eklex/LEscalierD/sch/module/photo/P1090374.JPG

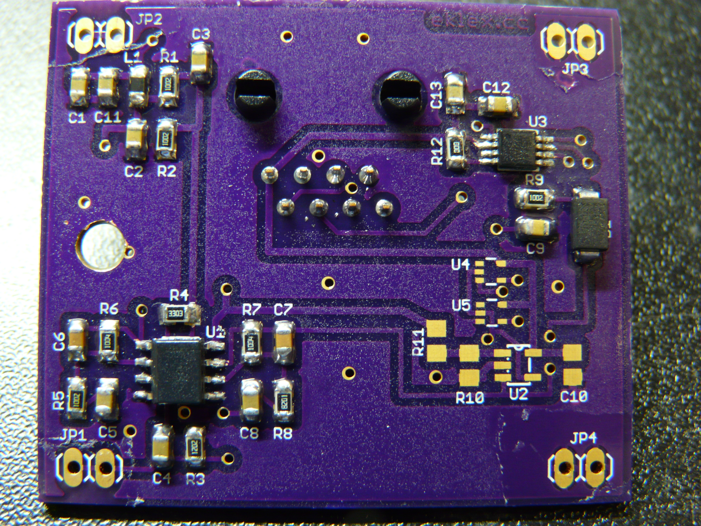
sch/module/photo/P1090374.JPG
