eklex/LEscalierD/sch/module/photo/P1090390.JPG

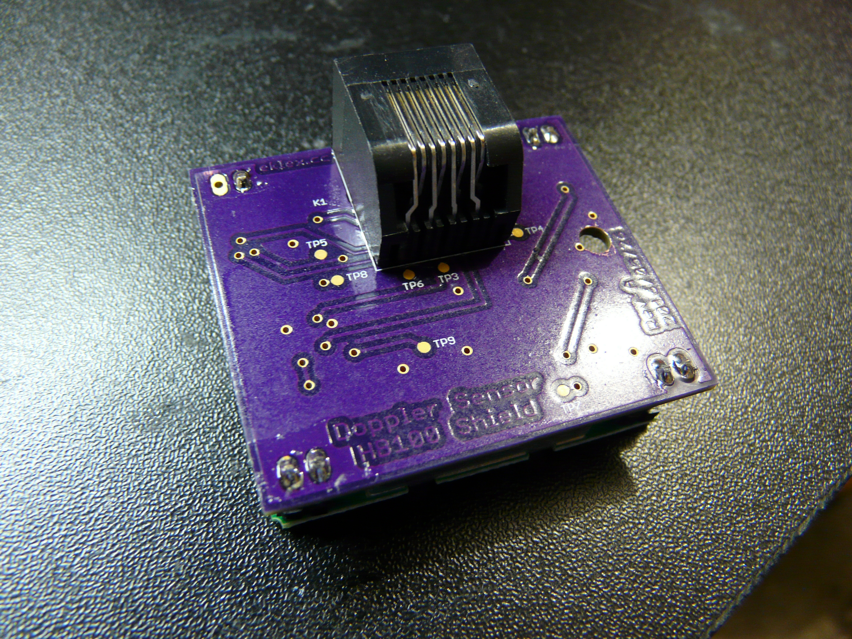
sch/module/photo/P1090390.JPG
