eklex/LEscalierD/sch/basecard/LEscalierD_brd_revA_bottom.png

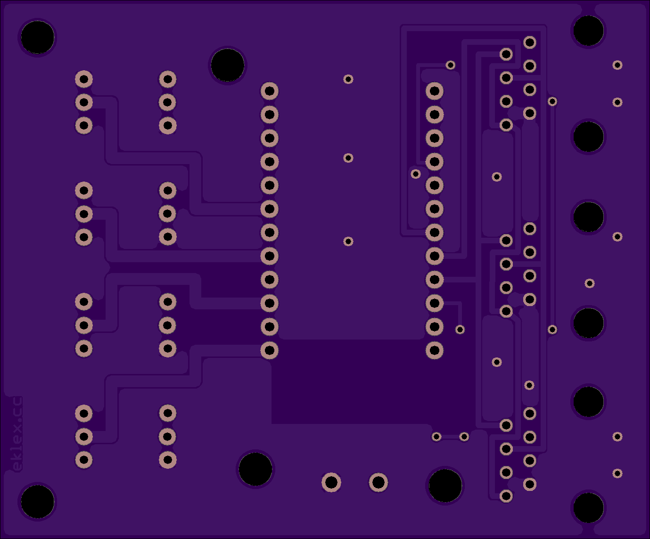
sch/basecard/LEscalierD_brd_revA_bottom.png
