eklex/LEscalierD/sch/basecard/LEscalierD_brd_revA_top.png

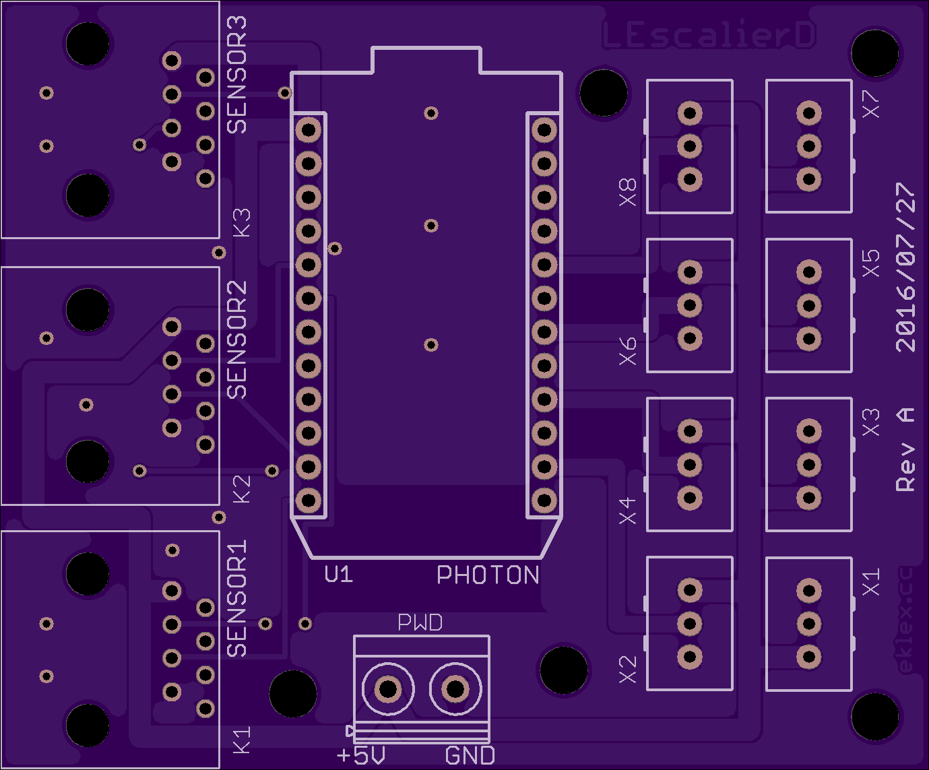
sch/basecard/LEscalierD_brd_revA_top.png
