eklex/LEscalierD/sch/basecard/photo/P1090511.JPG

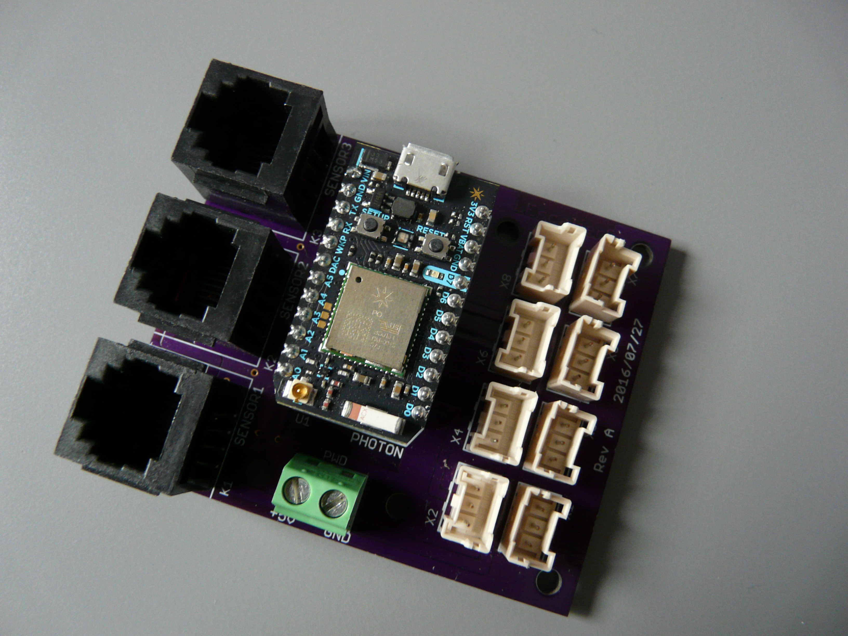
sch/basecard/photo/P1090511.JPG
