eklex/LEscalierD/sch/basecard/photo/P1090514.JPG

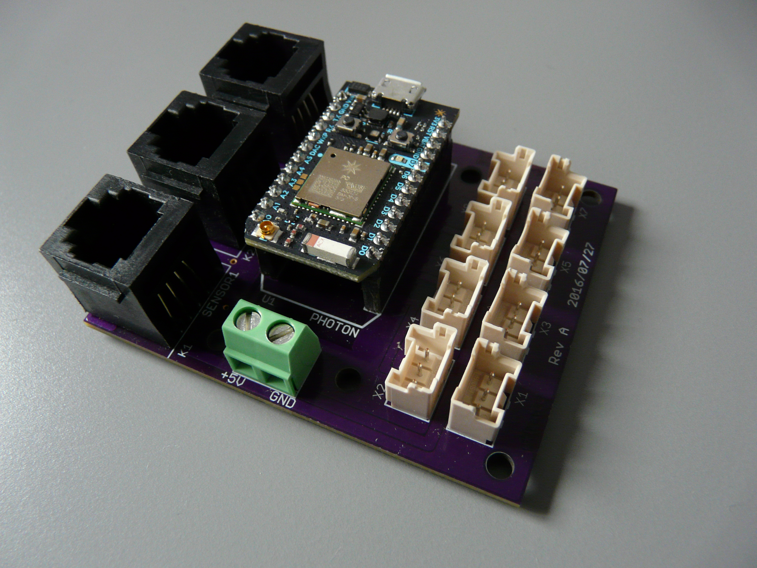
sch/basecard/photo/P1090514.JPG
