eklex/LEscalierD/sch/module/doppler_shield_brd_revB_bottom.png

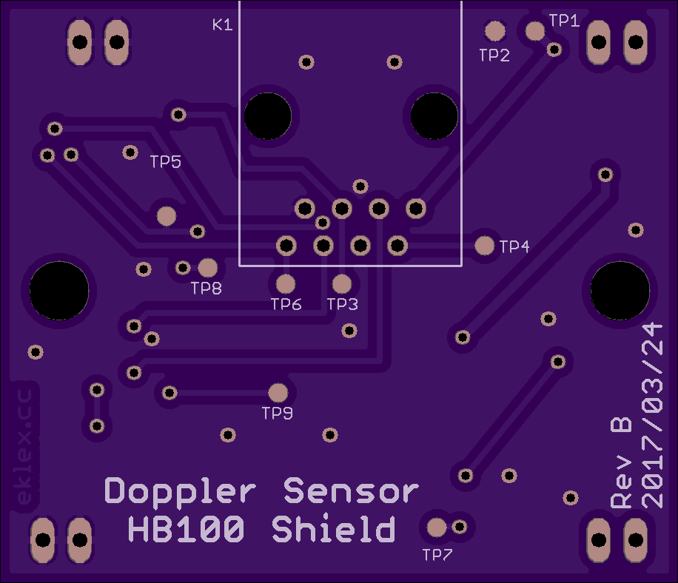
sch/module/doppler_shield_brd_revB_bottom.png
