eklex/LEscalierD/sch/module/doppler_shield_brd_revB_top.png

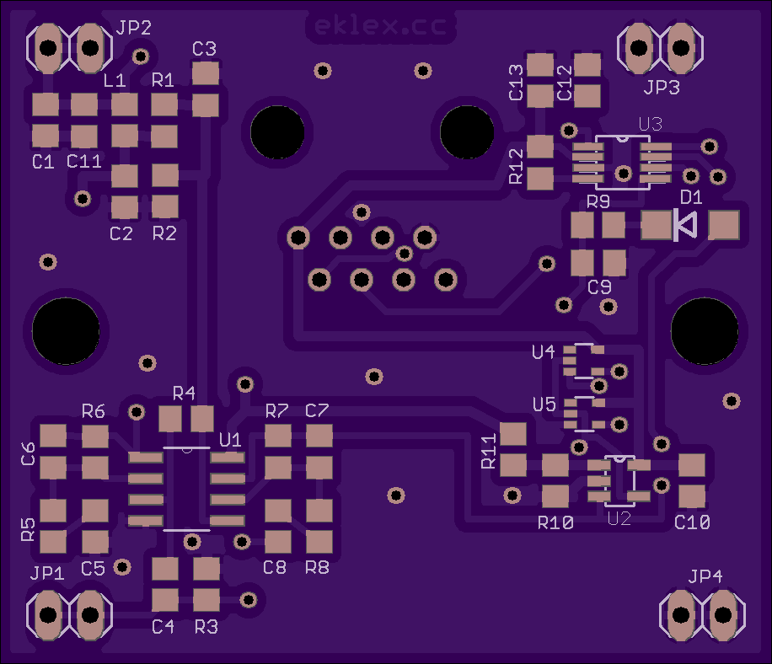
sch/module/doppler_shield_brd_revB_top.png
