eklex/LEscalierD/sch/module/photo/P1090385.JPG

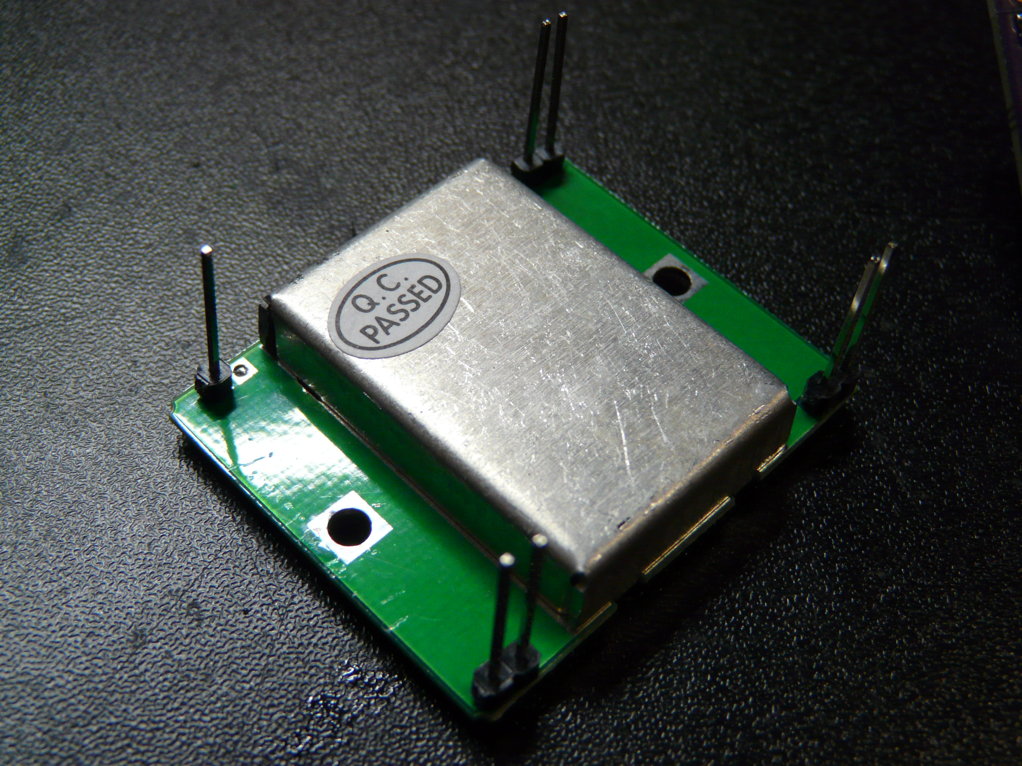
sch/module/photo/P1090385.JPG
