eklex/LEscalierD/sch/module/photo/P1090389.JPG

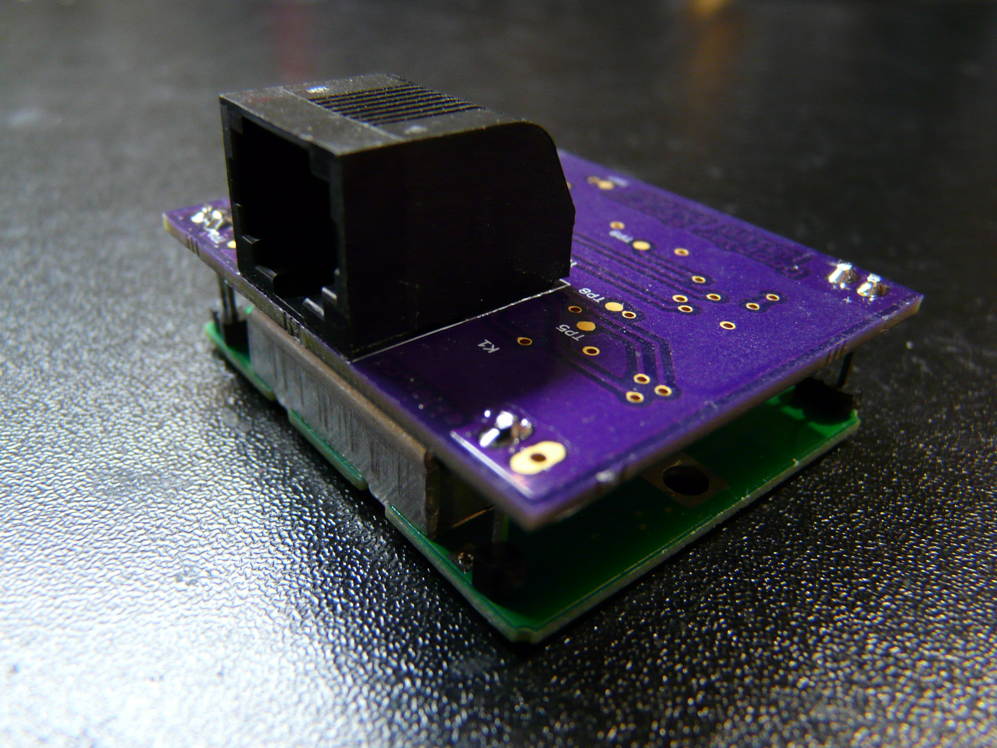
sch/module/photo/P1090389.JPG
