eklex/LEscalierD/sch/module/photo/P1090393.JPG

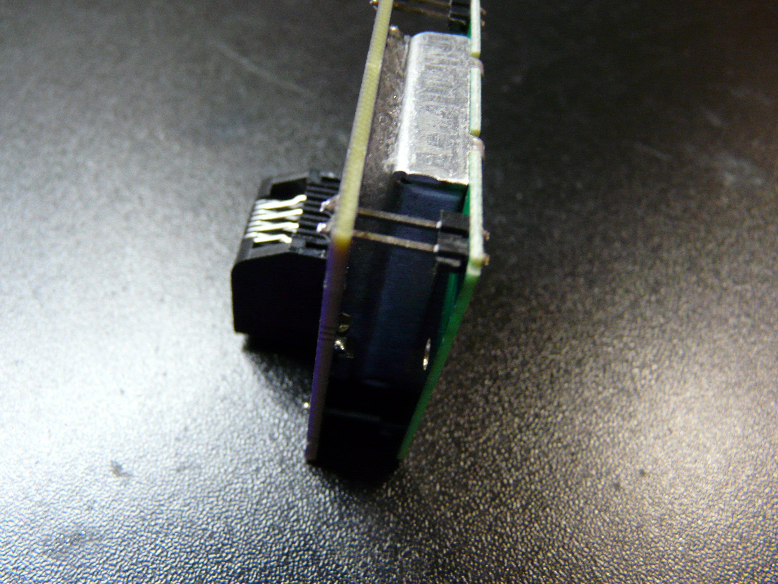
sch/module/photo/P1090393.JPG
