eklex/LEscalierD/sch/module/photo/P1090395.JPG

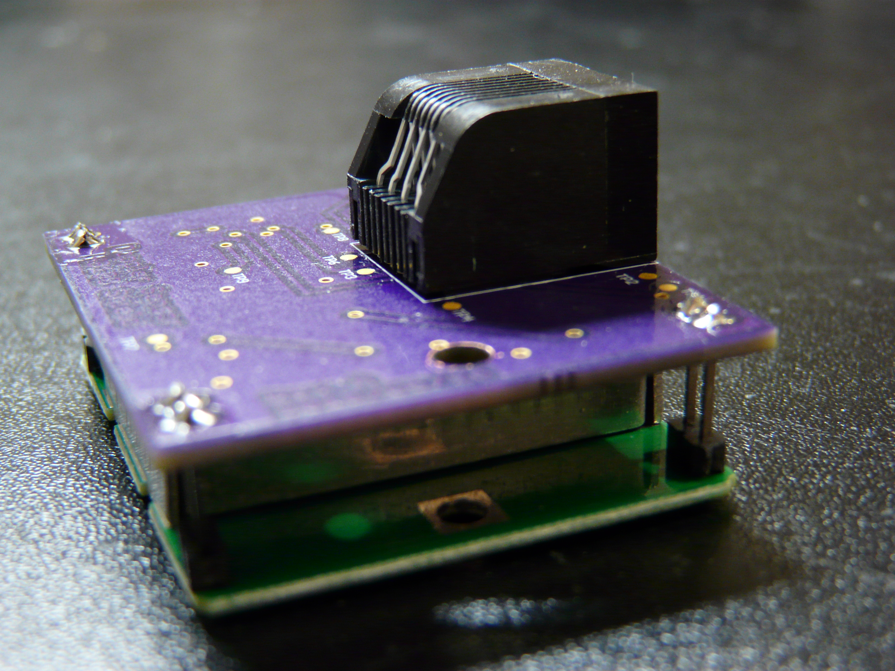
sch/module/photo/P1090395.JPG
