eklex/LEscalierD/sch/module/photo/P1090410.JPG

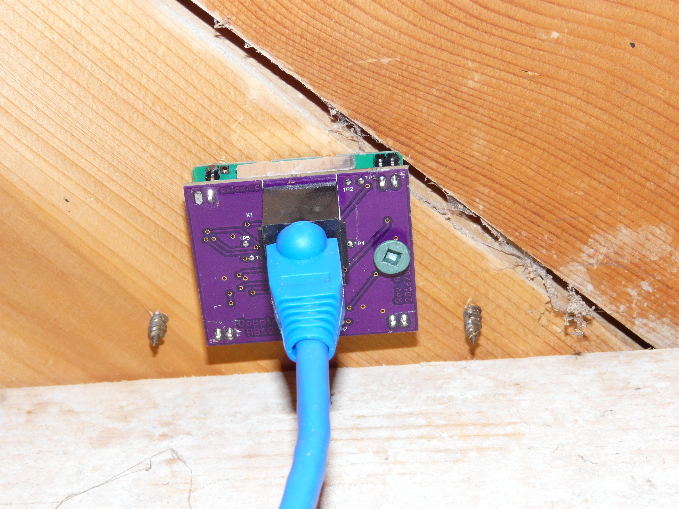
sch/module/photo/P1090410.JPG
