eklex/LEscalierD/sch/module/doppler_shield_bom_revB.xlsx

Sheet: BOM
Part | Quantity | Value | Eagle Device | Package | Part Number | Reference | Description
C1, C10, C13 | 3 | 100n | C-USC0805 | C0805 | 399-1170-1-ND (http://www.digikey.ca/scripts/DkSearch/dksus.dll?Detail&itemSeq=196558734&uq=635998726710660999) | SENS-C100N | CAP CER 0.1UF 50V X7R 0805
C2, C3, C9, C11, C12 | 5 | 10u | C-USC0805 | C0805 | 490-3886-1-ND (http://www.digikey.ca/scripts/DkSearch/dksus.dll?Detail&itemSeq=196558740&uq=635998726710650997) | SENS-C10U | CAP CER 10UF 16V X5R 0805
C4, C5, C8 | 3 | 4.7u | C-USC0805 | C0805 | 490-3335-1-ND (http://www.digikey.ca/scripts/DkSearch/dksus.dll?Detail&itemSeq=196558736&uq=635998726710660999) | SENS-C4.7U | CAP CER 4.7UF 25V X5R 0805
C6, C7 | 2 | 2.2n | C-USC0805 | C0805 | 399-1151-1-ND (http://www.digikey.ca/scripts/DkSearch/dksus.dll?Detail&itemSeq=196558733&uq=635998726710660999) | SENS-C2.2N | CAP CER 2200PF 50V X7R 0805
R1, R2, R5, R9, R10 | 5 | 10k | R-US_R0805 | R0805 | P10.0KCCT-ND (http://www.digikey.ca/scripts/DkSearch/dksus.dll?Detail&itemSeq=196558742&uq=635998726710640995) | SENS-R10K | RES SMD 10K OHM 1% 1/8W 0805
R3 | 1 | 12k | R-US_R0805 | R0805 | P12.0KCCT-ND (http://www.digikey.ca/scripts/DkSearch/dksus.dll?Detail&itemSeq=196558738&uq=635998726710640995) | SENS-R12K | RES SMD 12K OHM 1% 1/8W 0805
R4 | 1 | 330k | R-US_R0805 | R0805 | P330KCCT-ND (http://www.digikey.ca/scripts/DkSearch/dksus.dll?Detail&itemSeq=196558739&uq=635998726710650997) | SENS-R330K | RES SMD 330K OHM 1% 1/8W 0805
R6, R7 | 2 | 1M | R-US_R0805 | R0805 | P1.00MCCT-ND (http://www.digikey.ca/scripts/DkSearch/dksus.dll?Detail&itemSeq=196558737&uq=635998726710650997) | SENS-R1M | RES SMD 1M OHM 1% 1/8W 0805
R8, R11 | 2 | 8.2k | R-US_R0805 | R0805 | P8.20KCCT-ND (http://www.digikey.ca/scripts/DkSearch/dksus.dll?Detail&itemSeq=196558744&uq=635998726710630993) | SENS-R8.2K | RES SMD 8.2K OHM 1% 1/8W 0805
R12 | 1 | 0 | R-US_R0805 | R0805 | P0.0ACT-ND (http://www.digikey.ca/scripts/DkSearch/dksus.dll?Detail&itemSeq=198252034&uq=635998738667651919) | SENS-R0 | RES SMD 0.0 OHM JUMPER 1/8W 0805
L1 | 1 | FILTER | R-EU_R0805 | R0805 | HZ0805D102R-10 (http://www.digikey.ca/scripts/DkSearch/dksus.dll?Detail&itemSeq=198251175&uq=635998737494469204) | SENS-L1 | FERRITE BEAD 1 KOHM 0805 1LN
U1 | 1 | OPA2365AID | OPA2365AID | SOIC127 | OPA2365AIDR (http://www.digikey.ca/scripts/DkSearch/dksus.dll?Detail&itemSeq=198253137&uq=635998741464016119) | SENS-AOP | IC OPAMP GP 50MHZ RRO 8SOIC
U2 | 1 | MAX9031AUK+ | MAX9031AUK+ | SOT-23-5 | MAX9031AUK+TCT-ND (http://www.digikey.ca/scripts/DkSearch/dksus.dll?Detail&itemSeq=196558747&uq=635998738667611911) | SENS-CMP | IC COMPARATOR VOLT SGL SOT23-5
U3 | 1 | TSA7887ARMZ-REEL7 | AD7887ARMZ-REEL7 | 8-MSOP | TSA7887ARMZ-REEL (http://www.digikey.ca/scripts/DkSearch/dksus.dll?Detail&itemSeq=198253467&uq=635998743198149515) | SENS-ADC | IC ADC 12BIT 125KSPS 2CH 8-MSOP
U4 | 1 | 74LVC1G14DCK | 74LVC1G14DCK | SC-70-5 | SN74LVC1G14DCKR (http://www.digikey.ca/scripts/DkSearch/dksus.dll?Detail&itemSeq=198253730&uq=635998745416741352) | SENS-INV | IC SGL SCHMT-TRIG INVERT SC70-5
U5 | 1 | 74LVC1G17DCK | 74LVC1G17DCK | SC-70-5 | SN74LVC1G17DCKR (http://www.digikey.ca/scripts/DkSearch/dksus.dll?Detail&itemSeq=213396091&uq=636164644893759138) | SENS-BUF | IC BUFFER SCHMIT TRIG SC70-5
D1 | 1 | - | DIODE-DO214AC | DO-214AC | STPS1L30A (http://www.digikey.ca/scripts/DkSearch/dksus.dll?Detail&itemSeq=198253913&uq=635998746436135305) | SENS-D1 | DIODE SCHOTTKY 30V 1A SMA
K1 | 1 | - | 615008143721 | - | 615008143721 (http://www.digikey.ca/scripts/DkSearch/dksus.dll?Detail&itemSeq=196558735&uq=635998738667651919) | SENS-RJ45 | CONN MOD JACK 8P8C R/A UNSHLD
JP1, JP2, JP3, JP4 | 4 | - | PINHD-1X2 | 1X02 | Aliexpress (http://www.aliexpress.com/item/Free-Shipping-10pcs-1-40-40Pin-2-54mm-20mm-Long-Header-Pin-Male-Breakable-Pin-Header/1892073519.html) | SENS-CONN | PIN HEADER 2.54MM WIDTH 20MM LONG

Sheet: Eagle BOM
Part | Value | Device | Package | Description
C1 | 100n | C-USC0805 | C0805 | CAPACITOR, American symbol
C2 | 10u | C-USC0805 | C0805 | CAPACITOR, American symbol
C3 | 10u | C-USC0805 | C0805 | CAPACITOR, American symbol
C4 | 4.7u | C-USC0805 | C0805 | CAPACITOR, American symbol
C5 | 4.7u | C-USC0805 | C0805 | CAPACITOR, American symbol
C6 | 2.2n | C-USC0805 | C0805 | CAPACITOR, American symbol
C7 | 2.2nF | C-USC0805 | C0805 | CAPACITOR, American symbol
C8 | 4.7u | C-USC0805 | C0805 | CAPACITOR, American symbol
C9 | 10u | C-USC0805 | C0805 | CAPACITOR, American symbol
C10 | 100n | C-USC0805 | C0805 | CAPACITOR, American symbol
C11 | 10u | C-USC0805 | C0805 | CAPACITOR, American symbol
C12 | 10u | C-USC0805 | C0805 | CAPACITOR, American symbol
C13 | 100n | C-USC0805 | C0805 | CAPACITOR, American symbol
R1 | 10k | R-US_R0805 | R0805 | RESISTOR, American symbol
R2 | 10k | R-US_R0805 | R0805 | RESISTOR, American symbol
R3 | 12k | R-US_R0805 | R0805 | RESISTOR, American symbol
R4 | 330k | R-US_R0805 | R0805 | RESISTOR, American symbol
R5 | 10k | R-US_R0805 | R0805 | RESISTOR, American symbol
R6 | 1M | R-US_R0805 | R0805 | RESISTOR, American symbol
R7 | 1M | R-US_R0805 | R0805 | RESISTOR, American symbol
R8 | 8.2k | R-US_R0805 | R0805 | RESISTOR, American symbol
R9 | 10k | R-US_R0805 | R0805 | RESISTOR, American symbol
R10 | 10k | R-US_R0805 | R0805 | RESISTOR, American symbol
R11 | 8.2k | R-US_R0805 | R0805 | RESISTOR, American symbol
R12 | 0 | R-US_R0805 | R0805 | RESISTOR, American symbol
L1 | FILTER | R-EU_R0805 | R0805 | RESISTOR, European symbol
U1 | OPA2365AID | OPA2365AID | SOIC127P600X175-8N | OPERATIONAL AMPLIFIER
U2 | MAX9031AUK+ | MAX9031AUK+ | 21-0057F
U3 | TSA7887ARMZ-REEL7 | AD7887ARMZ-REEL7 | RM_8
U4 | 74LVC1G14DCK | 74LVC1G14DCK | SC70-5 | Single Schmitt-Trigger Inverter Gate
U5 | 74LVC1G17DCK | 74LVC1G17DCK | SC70-5 | Single Schmitt-Trigger Buffer
D1 |  | DIODE-DO214AC | DO214AC | DIODE
K1 | 615008143721 | 615008143721 | 615008143721 | WR-MJ Horizontal Plastic 8P8C Modular Jack Tab Down, 8 Pins=>Code : Con_I-O_MJ-H_Plastic_Down_615008143721
JP1 |  | PINHD-1X2 | 1X02 | PIN HEADER
JP2 |  | PINHD-1X2 | 1X02 | PIN HEADER
JP3 |  | PINHD-1X2 | 1X02 | PIN HEADER
JP4 |  | PINHD-1X2 | 1X02 | PIN HEADER
