eklex/LEscalierD/sch/basecard/LEscalierD_sch_revA.pdf

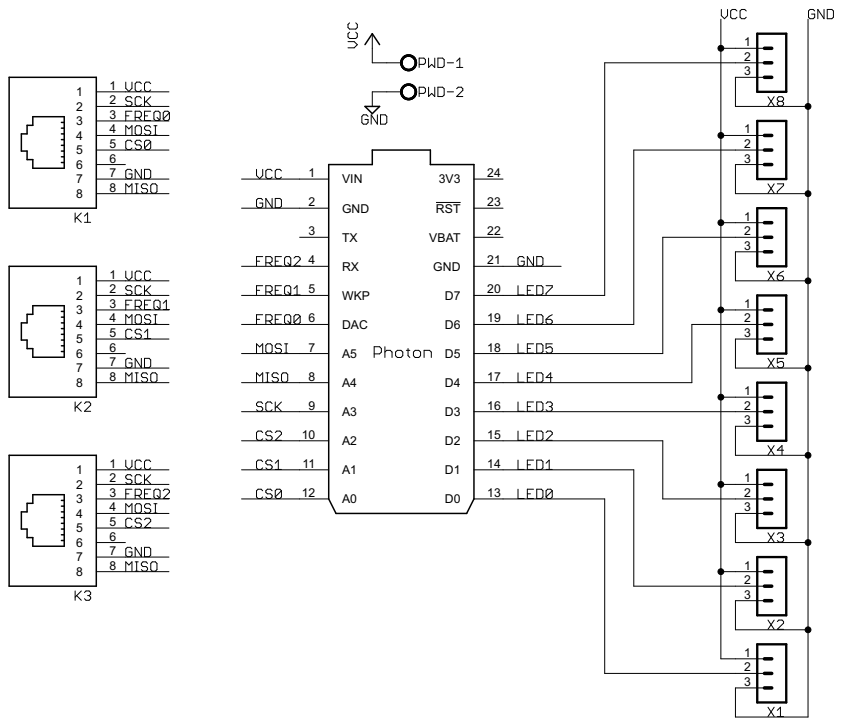
[picture p14: page 1]
