eklex/LEscalierD/sch/module/doppler_shield_sch_revB.pdf

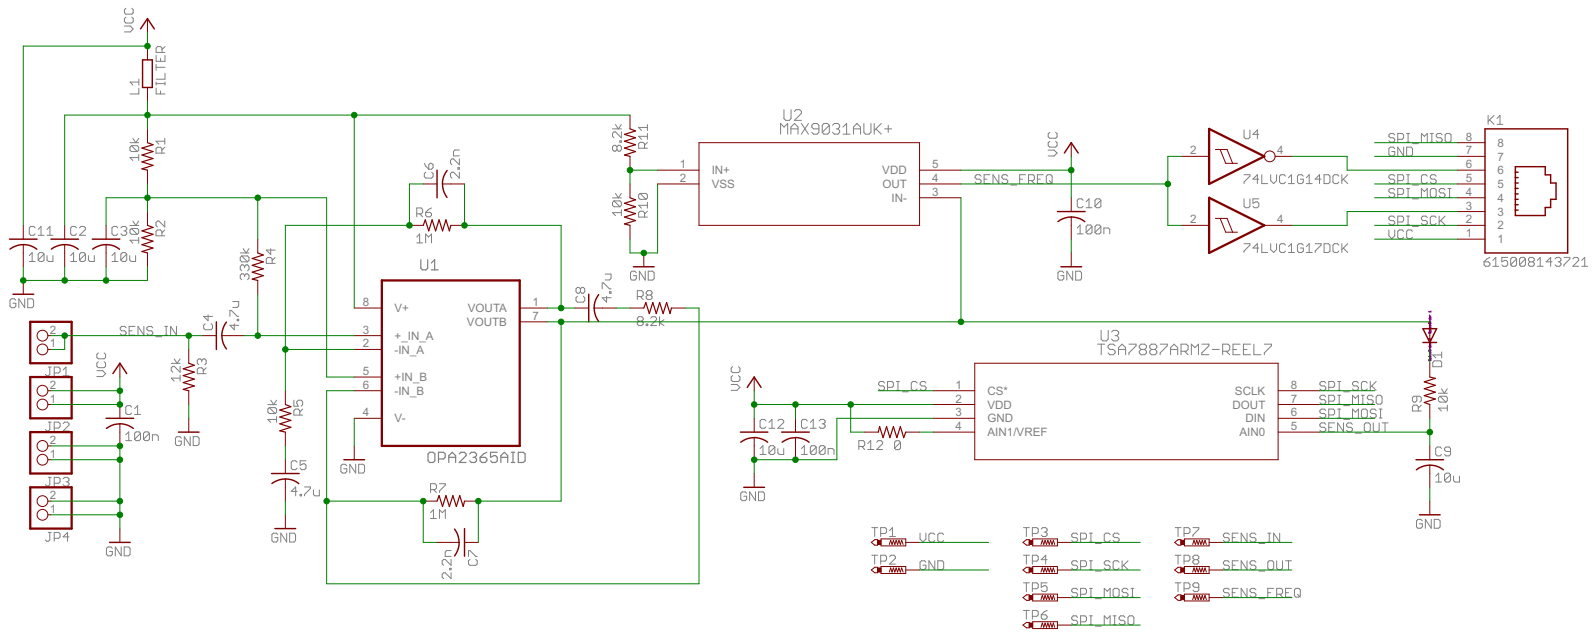
[picture p15: page 1]
