eklex/LEscalierD/sch/module/src/doppler_shield.brd

## EAGLE design sch/module/src/doppler_shield.brd (2017-03-25)

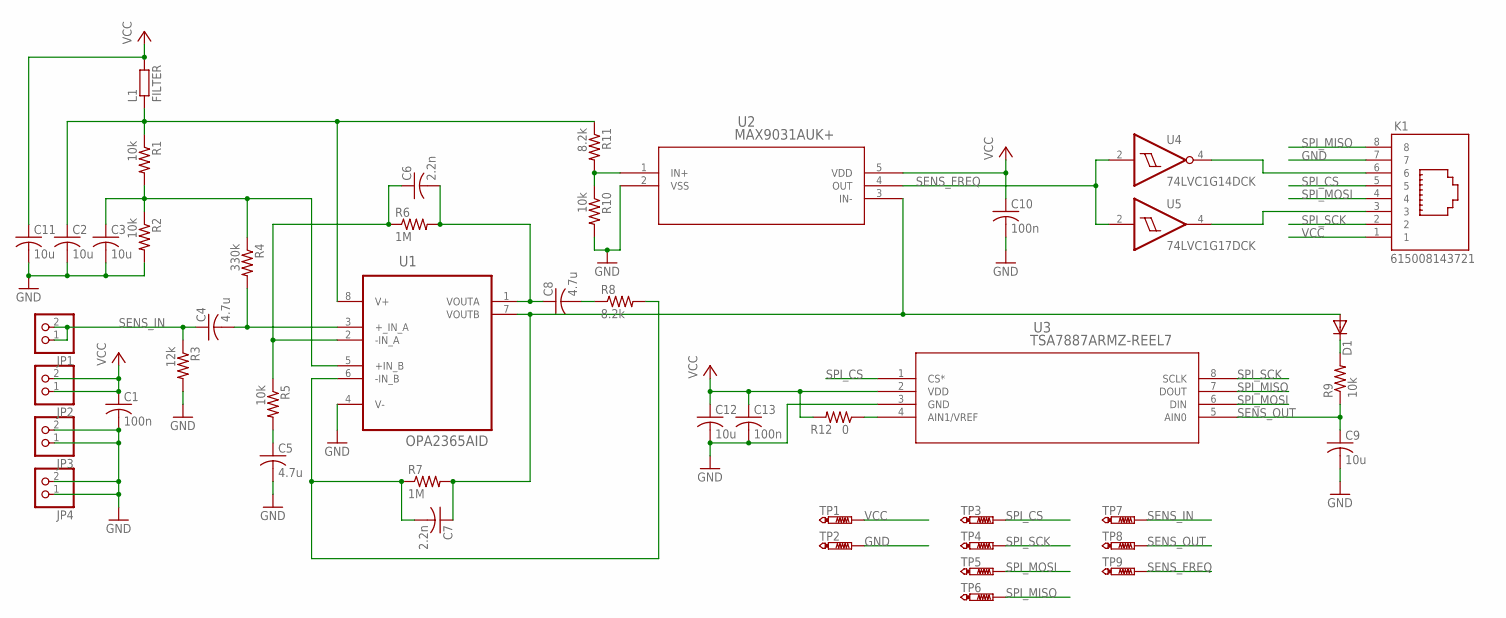
[picture p16: schematic doppler_shield.sch]

Parts:
C1, C10, C13: 100n; C0805
C2, C3, C9, C11, C12: 10u; C0805
C4, C5, C8: 4.7u; C0805
C6, C7: 2.2n; C0805
D1: DIODE-DO214AC; DO214AC
JP1, JP2, JP3, JP4: PINHD-1X2; 1X02
K1: 615008143721
L1: FILTER; R0805
R1, R2, R5, R9, R10: 10k; R0805
R3: 12k; R0805
R4: 330k; R0805
R6, R7: 1M; R0805
R8, R11: 8.2k; R0805
R12: 0; R0805
TP1, TP2, TP3, TP4, TP5, TP6, TP7, TP8, TP9: PTR1B1,27; B1,27
U1: OPA2365AID; SOIC127P600X175-8N
U2: MAX9031AUK+; 21-0057F
U3: TSA7887ARMZ-REEL7; RM_8
U4: 74LVC1G14DCK; SC70-5
U5: 74LVC1G17DCK; SC70-5

Connections:
GND: C1.2, C2.2, C3.2, C5.2, C9.2, C10.2, C11.2, C12.2, C13.2, JP3.1, JP3.2, JP4.1, JP4.2, K1.7, R2.2, R3.2, R10.2, TP2.TP, U1.4 (V-), U2.2 (VSS), U3.3 (GND), U4.3 (GND), U5.3 (GND)
unnamed: C3.1, R1.2, R2.1, R4.1, U1.5 (+IN_B)
unnamed: R10.1, R11.2, U2.1 (IN+)
unnamed: D1.C, R9.2
unnamed: R12.1, U3.4 (AIN1/VREF)
unnamed: K1.6, U4.4 (O)
unnamed: K1.3, U5.4 (O)
unnamed: C4.2, R4.2, U1.3 (+_IN_A)
unnamed: C5.1, R5.2
unnamed: C6.1, R5.1, R6.1, U1.2 (-IN_A)
unnamed: C6.2, C8.1, R6.2, U1.1 (VOUTA)
unnamed: C8.2, R8.1
unnamed: C7.2, R7.1, R8.2, U1.6 (-IN_B)
unnamed: C7.1, D1.A, R7.2, U1.7 (VOUTB), U2.3 (IN-)
SENS_FREQ: TP9.TP, U2.4 (OUT), U4.2 (I), U5.2 (I)
SENS_IN: C4.1, JP1.1, JP1.2, R3.1, TP7.TP
SENS_OUT: C9.1, R9.1, TP8.TP, U3.5 (AIN0)
SPI_CS: K1.5, TP3.TP, U3.1 (CS*)
SPI_MISO: K1.8, TP6.TP, U3.7 (DOUT)
SPI_MOSI: K1.4, TP5.TP, U3.6 (DIN)
SPI_SCK: K1.2, TP4.TP, U3.8 (SCLK)
VCC: C1.1, C10.1, C11.1, C12.1, C13.1, JP2.1, JP2.2, K1.1, L1.2, R12.2, TP1.TP, U2.5 (VDD), U3.2 (VDD), U4.5 (VCC), U5.5 (VCC)
VCC_AMP: C2.1, L1.1, R1.1, R11.1, U1.8 (V+)

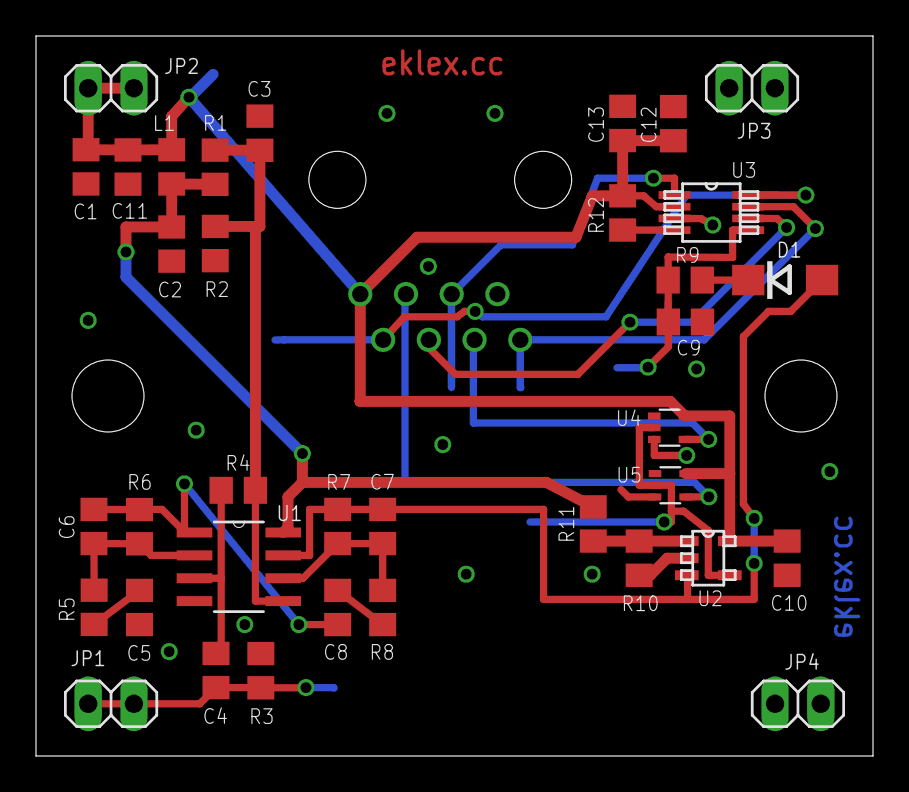
[picture p17: board doppler_shield.brd from above]

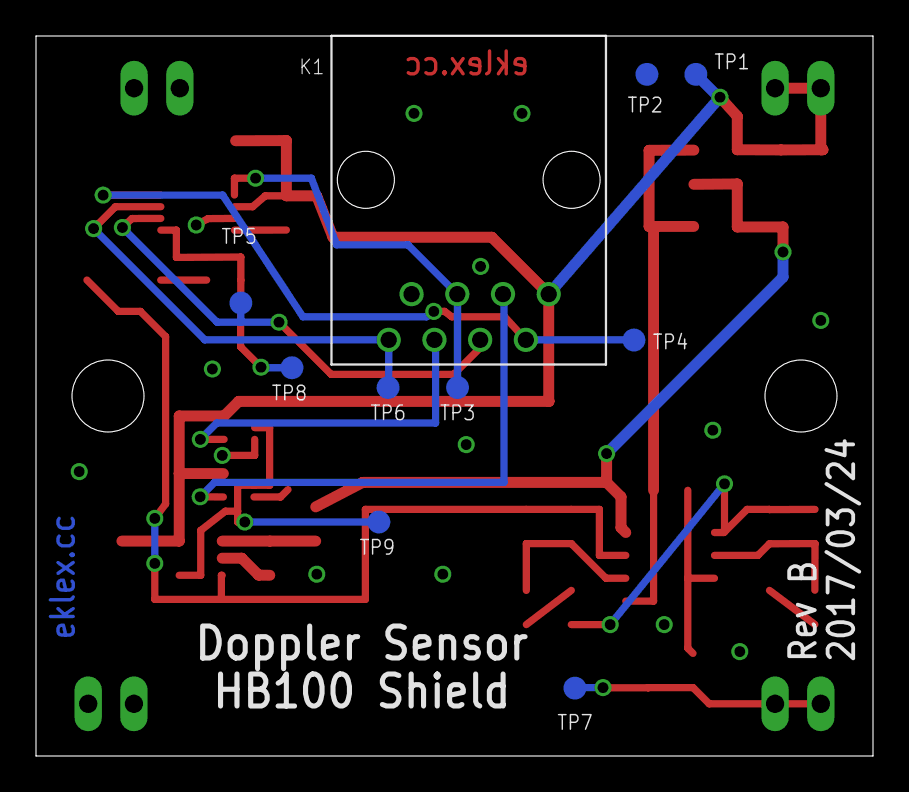
[picture p18: board doppler_shield.brd from below]

Board: 2 copper layers, 46.5 x 40.0 mm, 46 parts (10 on the bottom side), 23 nets.
