eklex/LEscalierD/sch/basecard/src/LEscalierD.brd

## EAGLE design sch/basecard/src/LEscalierD.brd (2016-12-04)

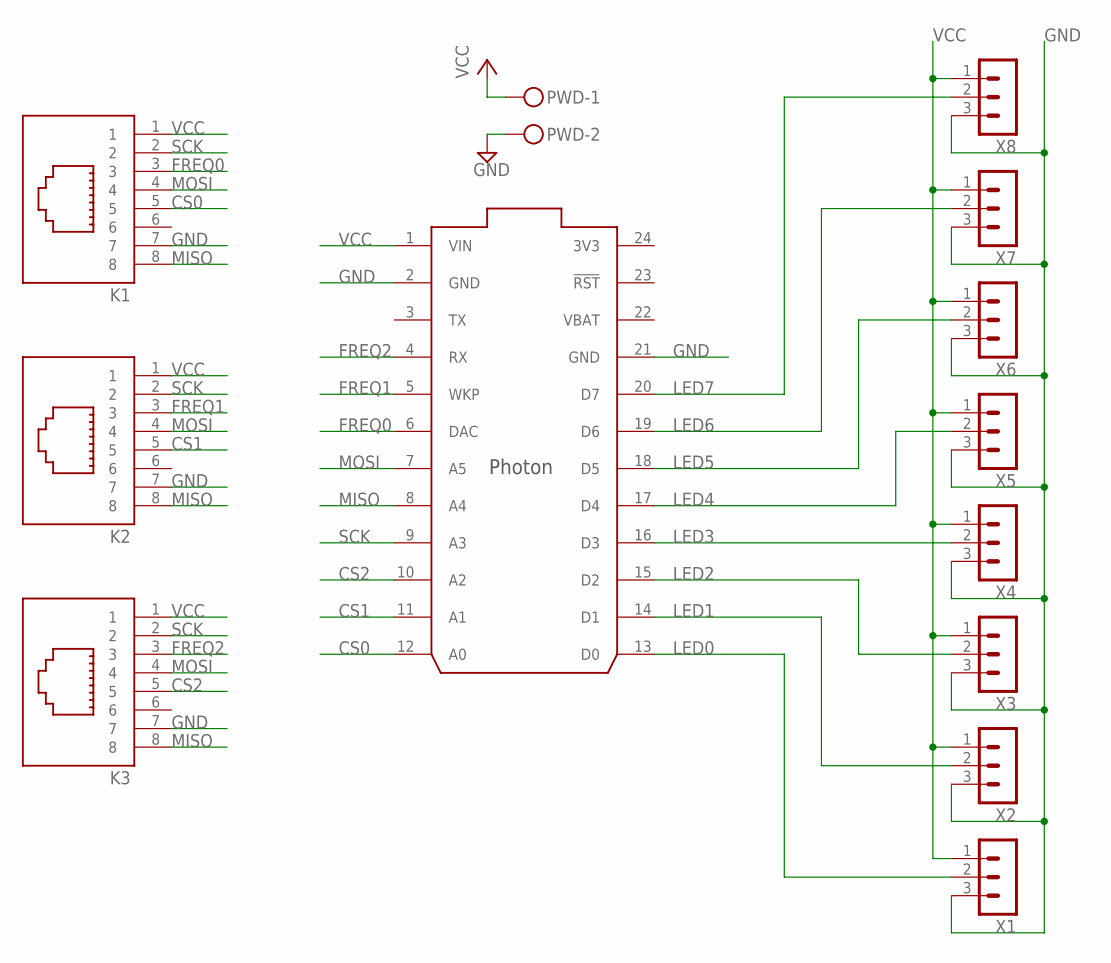
[picture p19: schematic LEscalierD.sch]

Parts:
K1, K2, K3: 615008144221
PWD: MKDSN1,5/2-5,08
U1: PHOTON_WITH_HEADERS; PHOTON
X1, X2, X3, X4, X5, X6, X7, X8: B3B-XASTD; B3B-XA

Connections:
3V3: U1.24 (3V3)
CS0: K1.5, U1.12 (A0)
CS1: K2.5, U1.11 (A1)
CS2: K3.5, U1.10 (A2)
FREQ0: K1.3, U1.6 (DAC)
FREQ1: K2.3, U1.5 (WKP)
FREQ2: K3.3, U1.4 (RX)
GND: K1.7, K2.7, K3.7, PWD.2, U1.2 (GND), U1.21 (GND), X1.3, X2.3, X3.3, X4.3, X5.3, X6.3, X7.3, X8.3
LED0: U1.13 (D0), X1.2
LED1: U1.14 (D1), X2.2
LED2: U1.15 (D2), X3.2
LED3: U1.16 (D3), X4.2
LED4: U1.17 (D4), X5.2
LED5: U1.18 (D5), X6.2
LED6: U1.19 (D6), X7.2
LED7: U1.20 (D7), X8.2
MISO: K1.8, K2.8, K3.8, U1.8 (A4)
MOSI: K1.4, K2.4, K3.4, U1.7 (A5)
SCK: K1.2, K2.2, K3.2, U1.9 (A3)
VBAT: U1.22 (VBAT)
VCC: K1.1, K2.1, K3.1, PWD.1, U1.1 (VIN), X1.1, X2.1, X3.1, X4.1, X5.1, X6.1, X7.1, X8.1

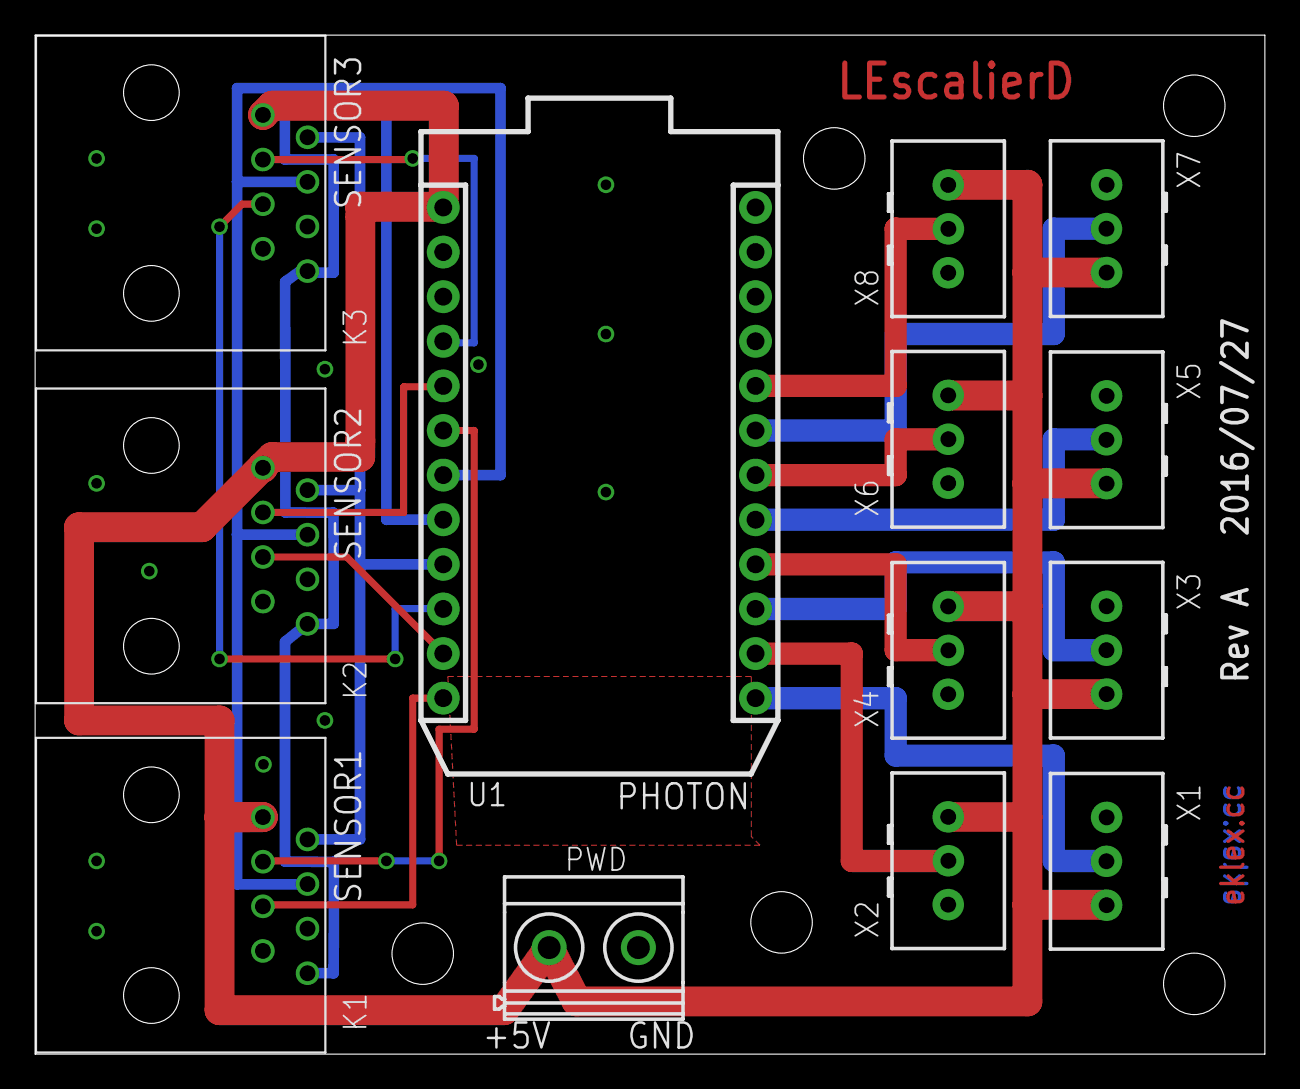
[picture p20: board LEscalierD.brd from above]

Board: 2 copper layers, 70.0 x 58.0 mm, 13 parts (0 on the bottom side), 19 nets.
