eklex/LEscalierD/src/FastLED/fastled_arm_stm32.h

#ifndef __INC_FASTLED_ARM_SAM_H
#define __INC_FASTLED_ARM_SAM_H

// Include the sam headers
#include "delay.h"
#include "fastpin_arm_stm32.h"
// #include "fastspi_arm_stm32.h"
#include "clockless_arm_stm32.h"

#endif
