eklex/LEscalierD/(commit log)

2016-02-28 cleaned-up accelerometer code
2016-02-29 added led specific files
2016-07-23 replaced accelero with ADC
    [ad7887.cpp, ad7887.h, debug.h, leds.cpp, leds.h, strips.cpp, strips.h]
2016-07-23 added center and sides animations and fixed cone animation
    [cloud.cpp, opening.cpp, strips.cpp, strips.h]
2016-10-03 adjusted pin configuration for final PCB
2016-12-04 added schematic and pcb for basecard and module
    [LEscalierD.brd, LEscalierD.sch, LEscalierD_bom.csv, doppler_shield.brd, doppler_shield.sch, doppler_shield_bom_revA.xlsx]
2017-03-25 Updated PCB of module card (doppler shield) to revB
    - Fixed JB3 position
    - Added 2 holes aligned on sensor's holes
    - No changes in schematic and BOM
    - Updated revision of SCH, PCB and BOM to revB
    [doppler_shield.brd, doppler_shield_bom_revB.xlsx]
