eklex/LEscalierD/(notices)

Notices in the files:
src/ad7887.cpp:
This program is free software: you can redistribute it and/or modify
it under the terms of the GNU General Public License as published by
the Free Software Foundation, version 3.
parts and their libraries:
Input-Output_Connectors_rev15d: Copyright: Würth Elektronik
analog-devices: COPYRIGHT: Copyright (C) 2015 Accelerated Designs. All rights reserved
